iampaviic/IoTGarage/OSTALO/README.md

# OSTALO – sve što ne spada pod PROJEKT ili SOFTWARE

- [literatura.md](literatura.md) – poveznice na dokumentaciju, specifikacije i datasheetove koje koristimo
  (ThingsBoard, MQTT, Mosquitto, OpenCV, Tesseract, ESP32, PlatformIO, senzori, alati); izvor za poglavlje
  *Literatura*
- `literatura/` – (dodaje se po potrebi) PDF-ovi preuzeti s mreže ili dobiveni od nastavnika: datasheetovi,
  članci, specifikacije
- [upute-nastavnika-gitlab.md](upute-nastavnika-gitlab.md) – upute nastavnika za arhiviranje projekta na
  GitLabu (struktura ovog repozitorija slijedi te upute)
