iampaviic/IoTGarage/PREZENTACIJA/README.md

# PREZENTACIJA – završna prezentacija i demonstracija

U uputama nastavnika ovaj dio se zove i *OBRANA*.

- [demo-scenarij.md](demo-scenarij.md) – scenarij demonstracije korak po korak, kontrolirane greške (nečitljiva
  pločica, izlaz bez sesije, …) i kontrolna lista prije prezentacije

Dodaje se do prezentacije:

- datoteka s prezentacijom u originalnom formatu (npr. `.pptx`) i njezina PDF verzija
- slike i grafovi iz prezentacije koji su napravljeni u nekom drugom alatu, u originalnom formatu (mapa `slike/`)
- rezervni video demonstracije (ili poveznica na njega, ako je prevelik za repozitorij)
