iampaviic/IoTGarage/SOFTWARE/rampe/simulator/README.md

# Simulator rampi

- `gate_sim.py` – Python verzija stroja stanja iz `firmware/lib/GateLogic` (ista pravila, isti testovi)
- `gate_simulator.py` – obje rampe na MQTT-u, prisutnost vozila s tipkovnice ili `garage/sim/gate/<gate>/presence`
- `test_gate_sim.py` – `pytest rampe/simulator` (iz mape SOFTWARE)
