iampaviic/IoTGarage/PROJEKT/upravljanje/sastanci/predlozak.md

# Sastanak YYYY-MM-DD (tjedan N)

Prisutni: Patrik ☐ · Lovro ☐ · Toma ☐ · Luka ☐ · Sven ☐ · Lukas ☐ · Anja ☐ · Leo ☐

## 1. Status

| tko | napravljeno od zadnjeg sastanka | plan do sljedećeg | blokira me |
|---|---|---|---|
| Patrik | | | |
| Lovro | | | |
| Toma | | | |
| Luka | | | |
| Sven | | | |
| Lukas | | | |
| Anja | | | |
| Leo | | | |

## 2. Demo integracije
Korak iz plana integracije: … · rezultat: prolaz / pad · bilješke:

## 3. Odluke (prepisati u odluke.md)
- 

## 4. Rizici (ažurirati rizici.md)
- 

## 5. Zadaci
| zadatak | tko | rok |
|---|---|---|
| | | |
