iampaviic/IoTGarage/SOFTWARE/alpr/tablice/plates_A4.pdf

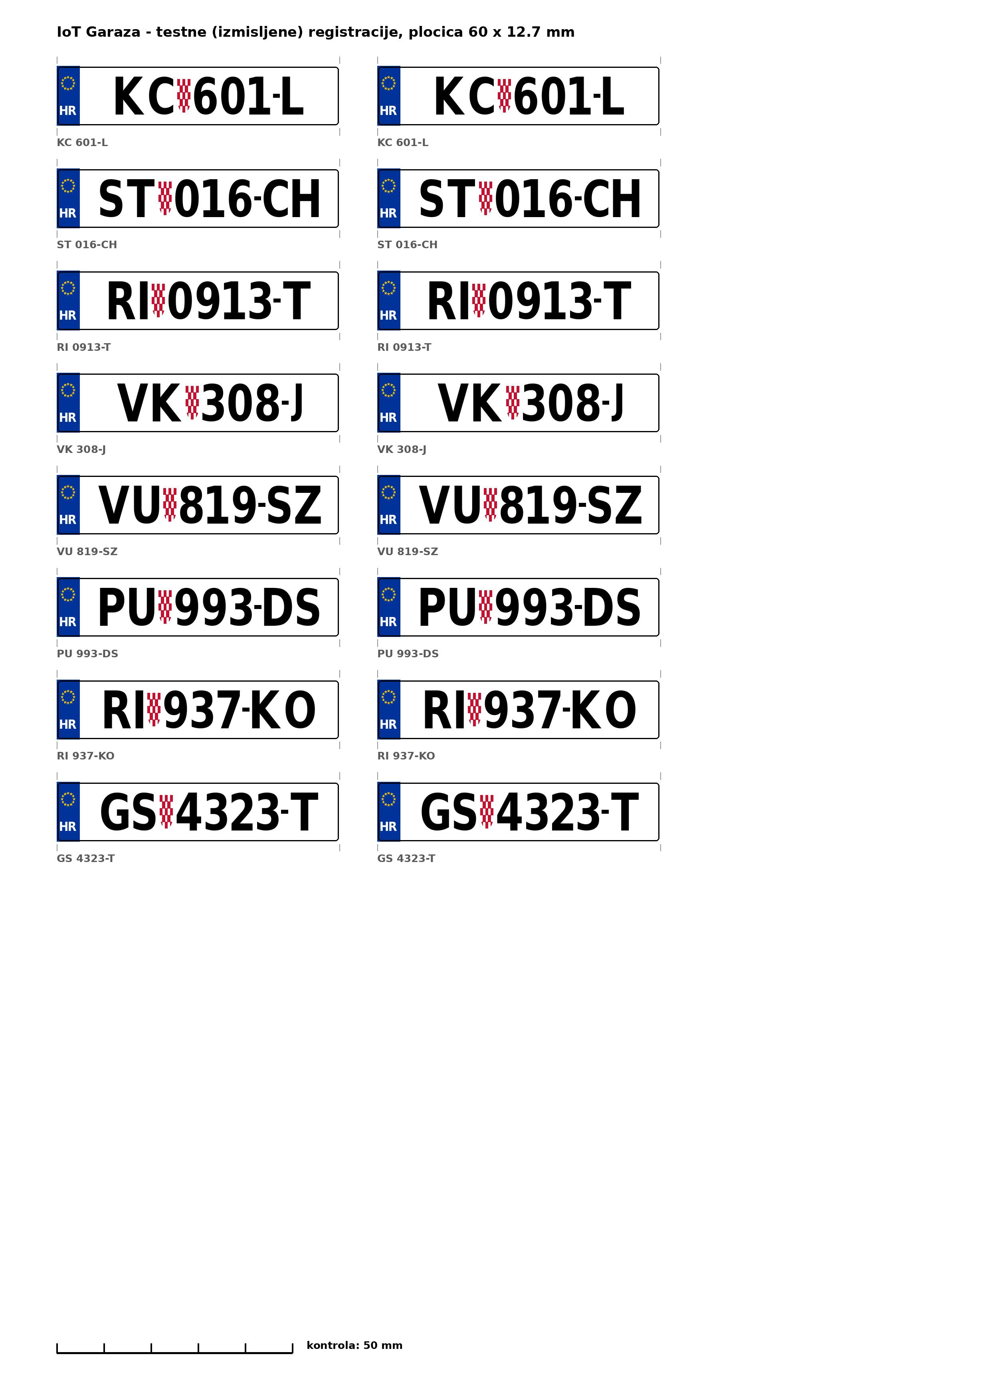
[picture p5: page 1]
