iampaviic/IoTGarage/SOFTWARE/maketa/elektronika/wireviz/cvor-rampi.bom.tsv

Id | Description | Qty | Unit | Designators
1 | Cable, 2 wires | 1.3 | m | R-IZ-TIPKA, R-PWR, R-UL-TIPKA, R-ZUJ
2 | Cable, 3 wires | 2.4 | m | R-IZ-IR, R-IZ-SERVO, R-IZ-SVJ, R-UL-IR, R-UL-SERVO, R-UL-SVJ
3 | Connector, 5 V / 4 A adapter (zajednicko), 2 pins | 1 |  | NAPAJANJE
4 | Connector, ESP32 DevKit V1 (cvor rampi), 14 pins | 1 |  | ESP32-R
5 | Connector, FC-51 (izlaz) - napajati s 3.3 V!, 3 pins | 1 |  | IR-IZ
6 | Connector, FC-51 (ulaz) - napajati s 3.3 V!, 3 pins | 1 |  | IR-UL
7 | Connector, LED crvena+zelena s 220 Ohm (izlaz), 3 pins | 1 |  | SVJ-IZ
8 | Connector, LED crvena+zelena s 220 Ohm (ulaz), 3 pins | 1 |  | SVJ-UL
9 | Connector, SG90 (izlaz), 3 pins | 1 |  | SERVO-IZ
10 | Connector, SG90 (ulaz), 3 pins | 1 |  | SERVO-UL
11 | Connector, aktivna zujalica 3.3 V (opcionalno), 2 pins | 1 |  | ZUJALICA
12 | Connector, tipkalo rucno otvaranje (izlaz), 2 pins | 1 |  | TIPKA-IZ
13 | Connector, tipkalo rucno otvaranje (ulaz), 2 pins | 1 |  | TIPKA-UL
