iampaviic/IoTGarage/SOFTWARE/maketa/3d/sklop/sklop_makete.stl

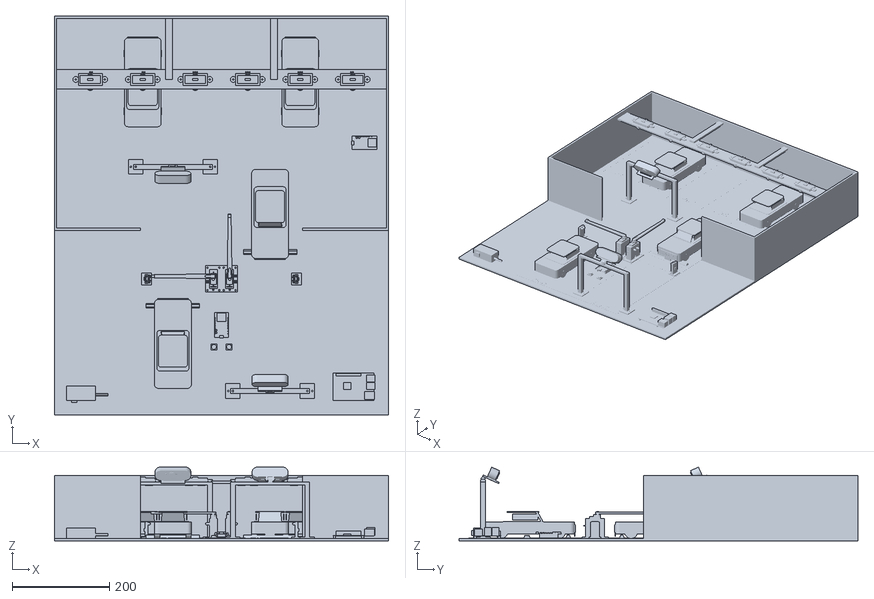
[picture p6: CAD file, 2026-11-04]
SOFTWARE/maketa/3d/sklop/sklop_makete.stl
688.0 x 821.0 x 151.8
