iampaviic/IoTGarage/SOFTWARE/maketa/3d/stl/most_kamere.stl

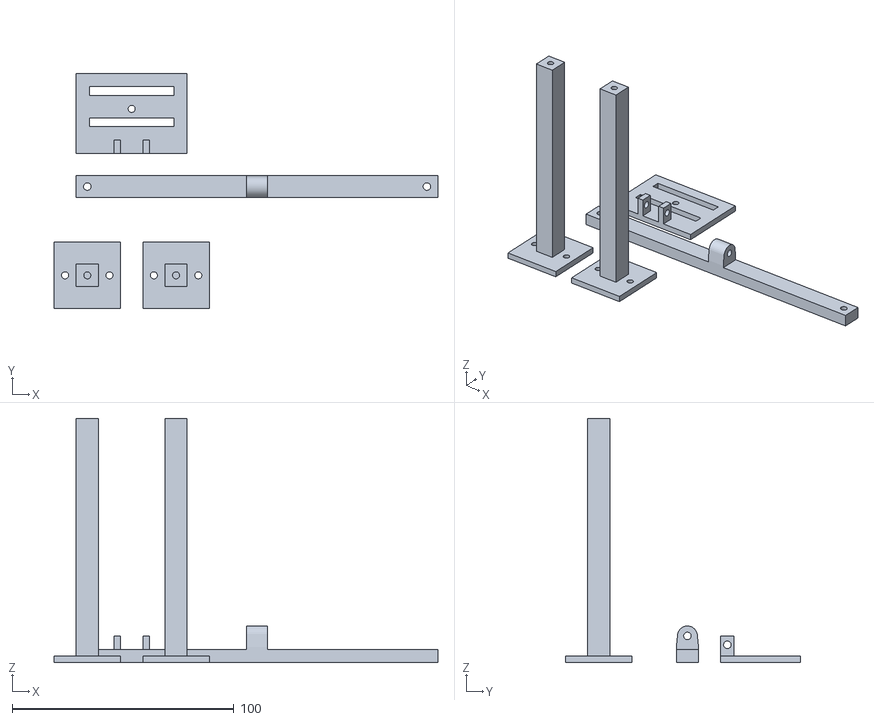
[picture p7: CAD file, 2026-11-04]
SOFTWARE/maketa/3d/stl/most_kamere.stl
173.0 x 106.0 x 110.0
