iampaviic/IoTGarage/SOFTWARE/maketa/3d/stl/rampa_sg90.stl

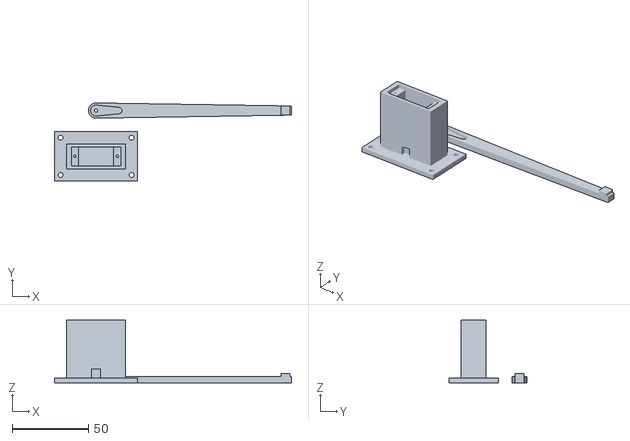
[picture p8: CAD file, 2026-10-21]
SOFTWARE/maketa/3d/stl/rampa_sg90.stl
155.2 x 51.2 x 41.0
