iampaviic/IoTGarage/SOFTWARE/maketa/3d/stl/kabelski_kanal.stl

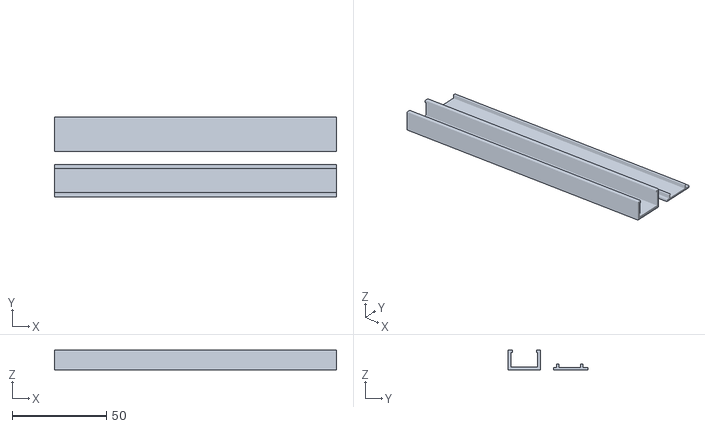
[picture p9: CAD file, 2026-10-21]
SOFTWARE/maketa/3d/stl/kabelski_kanal.stl
150.0 x 42.4 x 10.6
