iampaviic/IoTGarage/SOFTWARE/maketa/3d/stl/nosac_hcsr04.stl

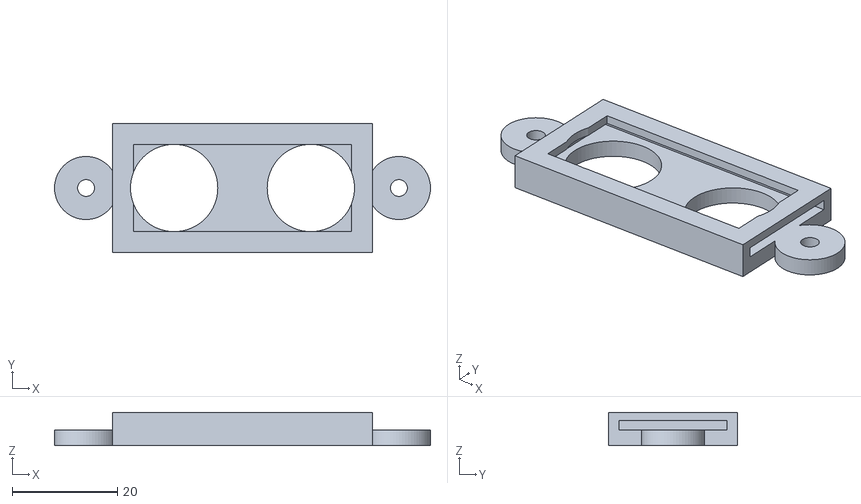
[picture p10: CAD file, 2026-10-21]
SOFTWARE/maketa/3d/stl/nosac_hcsr04.stl
71.5 x 24.5 x 6.30
