iampaviic/IoTGarage/SOFTWARE/maketa/3d/stl/drzac_tablice.stl

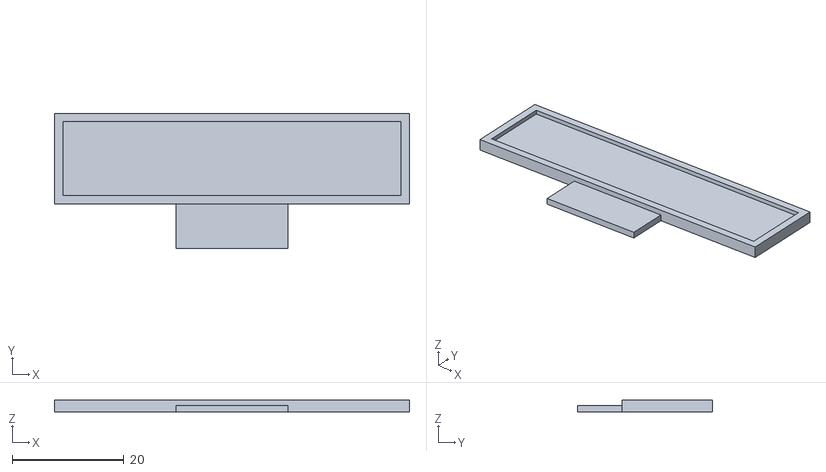
[picture p11: CAD file, 2026-10-21]
SOFTWARE/maketa/3d/stl/drzac_tablice.stl
63.5 x 24.2 x 2.20
