iampaviic/IoTGarage/SOFTWARE/maketa/3d/stl/nosac_ir.stl

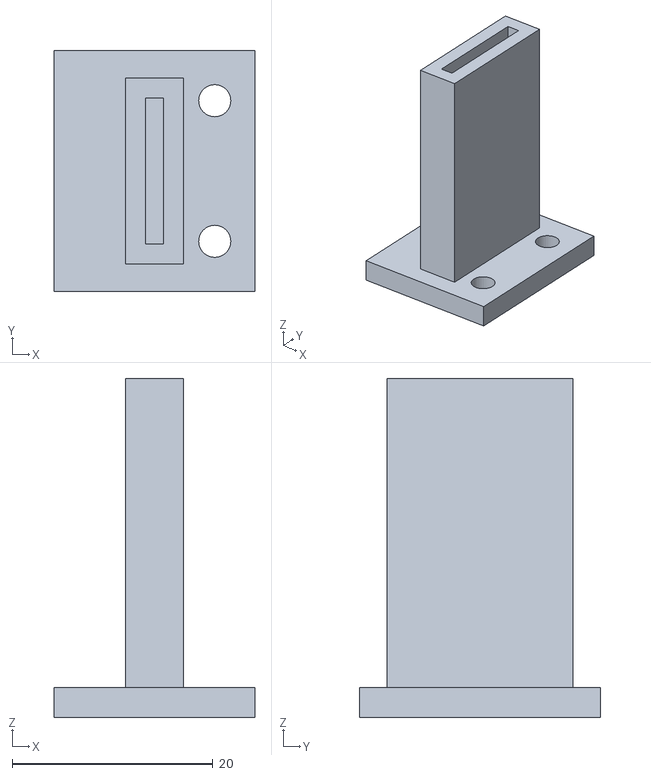
[picture p12: CAD file, 2026-10-21]
SOFTWARE/maketa/3d/stl/nosac_ir.stl
20.0 x 24.0 x 33.8
