iampaviic/IoTGarage/SOFTWARE/maketa/3d/stl/granicnik.stl

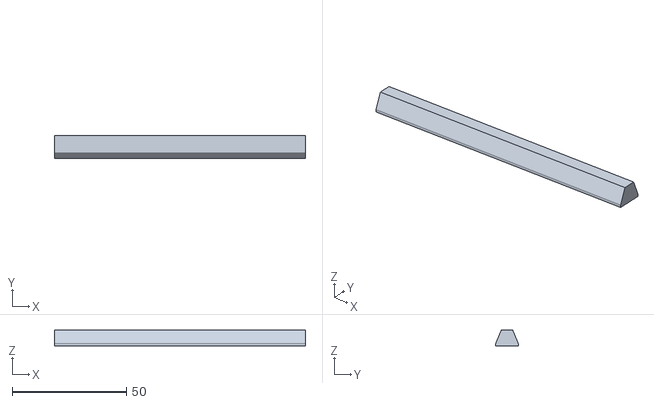
[picture p13: CAD file, 2026-10-21]
SOFTWARE/maketa/3d/stl/granicnik.stl
110.0 x 10.0 x 7.00
