iampaviic/IoTGarage/SOFTWARE/maketa/nacrt/dimenzije.md

# Dimenzije makete (generirano: `python alati/tlocrt.py --scale 24 --spots 6`)

| element | mjera |
|---|---|
| baza makete (Š x D) | 688 x 821 mm |
| parkirno mjesto (Š x D) | 108 x 221 mm |
| prometnica (širina) | 200 mm |
| ulazna/izlazna traka (širina) | 133 mm |
| otok između traka | 67 mm |
| duljina vozila 1:24 (približno) | 183 mm |
| kamera iza crte rampe (na mostu iznad trake) | 200 mm, objektiv 130 mm iznad poda |
| zaustavna crta ispred rampe | 40 mm |
| ruka rampe (donji/gornji rub) | 50 / 58 mm iznad poda |
| HC-SR04 iznad poda (strop mosta) | 113 mm |
