iampaviic/IoTGarage/PROJEKT/maketa/foto-dnevnik/README.md

# Foto-dnevnik izrade

Isporučivi rezultat su i **fotografije faza izrade**. Pravila:

- naziv: `YYYY-MM-DD_faza-N_opis.jpg`, faze iz [nacrt-makete.md](../nacrt-makete.md) §5
- svaka faza: 1 pregledna + 1–2 detalja (spojevi, montaža)
- prije zatvaranja kanala: fotografija ožičenja s vidljivim oznakama kabela

| datum | faza | fotografija | bilješka |
|---|---|---|---|
| | | | |
