iampaviic/IoTGarage/PROJEKT/testiranje/tablica-pragova.md

# Tablica pragova po mjestu

Popunjava se iz izlaza `python SOFTWARE/senzori/tools/kalibracija.py` (datum, uvjeti). Iste vrijednosti idu u
`firmware/include/config.h` → `SPOTS[]`.

Datum kalibracije: ____  · visina mosta senzora: ____ mm · autić: ____

| mjesto | prazno [cm] | σ | auto [cm] | σ | zauzeto ispod [cm] | slobodno iznad [cm] | izgubljenih mjerenja | ocjena |
|---|---|---|---|---|---|---|---|---|
| P01 | | | | | | | | |
| P02 | | | | | | | | |
| P03 | | | | | | | | |
| P04 | | | | | | | | |
| P05 | | | | | | | | |
| P06 | | | | | | | | |

Zadane vrijednosti u firmwareu (prije kalibracije): zauzeto ispod 10,0 cm, slobodno iznad 12,0 cm.
