iampaviic/IoTGarage/(commit log)

2026-10-21 Add ESP32 firmware for spot sensors and gates with native unit tests, sensor calibration and 20x test tools
    Claude-Session: https://claude.ai/code/session_01PjtoX6XUzfEavShmoGESuF
2026-10-21 Add physical model tools (floor plan, camera calculator, 3D parts, wiring diagrams), edge deployment, CI and root test config
    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
    [cvor-rampi.bom.tsv, cvor-senzora.bom.tsv, drzac_tablice.scad, drzac_tablice.stl, granicnik.scad, granicnik.stl, kabelski_kanal.scad, kabelski_kanal.stl]
2026-10-21 Add documentation for all eight team folders: architecture, contract, plans, build guide, test plan and log, user guide
    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
    [popis-komponenti.csv]
2026-10-21 Clarify duplicate MQTT client warning; simulated broken spot reports real fault status
    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
    [main.cpp]
2026-10-21 Ignore duplicate/stale ALPR answers; make camera device mapping a compose override
    - access control: each ALPR attempt gets its own requestId and an answer is only
    used while the transaction is waiting for it, so a QoS 1 redelivery no longer
    produces a second (wrong) decision
    - edge compose: /dev/video0 moved to docker-compose.camera.yml so the base file
    also starts on machines without a camera (ALPR_SOURCE defaults to sim)
    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
2026-10-22 Restructure repository to the GitLab archive layout required by the course
    Top level now follows the professor's instructions: README.TXT, PROJEKT,
    SOFTWARE, PREZENTACIJA, OSTALO, each with a README.TXT.
    - SOFTWARE: all code, one folder per subsystem (ugovor, integracija,
    senzori, rampe, alpr, edge, thingsboard, baza, maketa), plus INSTALL.TXT,
    requirements-dev.txt, pytest.ini, placeholders for the mobile app and
    the final executables
    - PROJEKT: plan projekta (DOCX + PDF + figure sources), final documentation
    chapters, architecture/contract/requirements, management docs, model
    docs, testing docs, screenshots
    - PREZENTACIJA: demo script; OSTALO: literature links and the instruction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
    [cvor-rampi.bom.tsv, cvor-senzora.bom.tsv, drzac_tablice.scad, drzac_tablice.stl, granicnik.scad, granicnik.stl, kabelski_kanal.scad, kabelski_kanal.stl]
2026-10-22 Convert remaining text documents to Markdown
    INSTALL.TXT becomes INSTALL.md and the professor's instructions become
    upute-nastavnika-gitlab.md (content unchanged, only formatted). Links
    and references updated. requirements-dev.txt, the font licence and the
    generated plate list stay .txt because tools read or produce them as
    plain text.
    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
2026-10-28 Gantt: subsystem tasks start in week 3
    Sensor firmware, barrier firmware, ALPR camera/photos, ThingsBoard
    installation and the session model now start on 2.11. (week 3) instead
    of 26.10.; their end dates are unchanged. The plan DOCX/PDF will be
    updated together with the team's new control point dates.
    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
2026-10-28 Architecture block diagram: generic component names, mobile app
    - HC-SR04, SG90 and WS2812 replaced by "UZV senzor", "servo motor" and
    "LED"; the edge subgraph is just "Edge računalo"
    - the mobile app is shown on a phone, reading data from ThingsBoard over
    the REST API (it never talks to the edge computer)
    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
2026-10-28 Architecture: generic component and platform names throughout
    - block diagram: "MQTT broker" instead of Mosquitto
    - component table: UZV senzor, servo motor, IR senzor, LED instead of
    HC-SR04, SG90 and the LED strip
    - deployment: "edge računalo" instead of Raspberry Pi / Jetson Nano; the
    recommendation paragraph now just says any Linux computer with Docker
    or Python >= 3.8 works and points to decision D-004
    - degraded mode and security: "MQTT broker" instead of Mosquitto
    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
2026-10-29 Architecture: variant B that relies on ThingsBoard
    New section 9 next to the existing (variant A) diagrams, which stay:
    - block diagram without the edge MQTT broker, SQLite and bridge: devices
    use ThingsBoard's built-in MQTT transport, sessions live in its database,
    decisions/pricing/alarms run in a rule chain; the edge computer only
    runs ALPR (can be the ThingsBoard laptop)
    - matching entry and exit sequence diagrams (two-way RPC readPlate to the
    ALPR device, RPC open to the gate)
    - A/B comparison and what would change in code if the team picks B
    Checked against the ThingsBoard docs source (MQTT device API, RPC,
    telemetry/attributes storage, rule node reference).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
2026-10-29 Model: 3D assembly of the whole physical model
    sklop/sklop_makete.scad places every printed part (barrier posts and arms,
    HC-SR04 and FC-51 holders, camera bridges, plate holders, wheel stops) on
    the base, together with simplified models of the purchased components
    (komponente.scad): HC-SR04, SG90, FC-51, USB cameras, WS2812 and 5 mm
    LEDs, buttons, ESP32 nodes, Raspberry Pi, power supply and 1:24 cars with
    plates. The layout uses the same formulas as alati/tlocrt.py.
    The assembly computes the camera tilt from the geometry and renders the
    view from each camera: the barrier arm passes above the plate, matching
    kamera_kalkulator.py. izvoz.py exports the PNG views, one STL (viewable
    on GitHub/G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
    [drzac_tablice.scad, granicnik.scad, komponente.scad, most_kamere.scad, most_kamere.stl, nosac_hcsr04.scad, nosac_ir.scad, sklop_makete.scad]
2026-10-29 Architecture: fix variant B flows, make diagram text fit
    Variant B (ThingsBoard) logic:
    - Manual approval now goes through the rule chain: the dashboard button
    sends RPC approve with the plate, the rule chain opens the session and
    only then opens the barrier. Before, the button opened the barrier
    directly, so the same car got NO_ACTIVE_SESSION at the exit.
    - A full garage or a car already inside is denied (GARAGE_FULL /
    ALREADY_INSIDE, as in variant A) instead of going to manual approval.
    - An ALPR RPC timeout counts as low confidence.
    - The exit checks OCR confidence too and has a manual path; both flows
    end with the barrier closing on its own.
    Readability: flowchart nodes and ed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
2026-10-30 Architecture: keep the servo box out of the MQTT label's way
    In both block diagrams the servo node sat right of the gate ESP32, where
    the label of the ESP32's MQTT link is drawn, and covered it. The servo
    is now linked like the spot LED, so it is laid out left of the ESP32.
    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
2026-10-30 Edge deploy: local settings in .env; gate angle comments match the arm
    docker-compose.edge.yml read the ThingsBoard address, gateway token and
    config path from hard-coded values, so setting up the Raspberry Pi meant
    editing a tracked file and getting conflicts on every git pull. They now
    come from edge/deploy/.env (git-ignored, template .env.example), with the
    old values as defaults. docker compose config resolves both with and
    without .env.
    The gate firmware and README said the open arm stands vertical; the
    printed arm swings horizontally, so the comments now say across the lane
    / along the island.
    Claude-Session: https://claude.ai/c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
    [config.h]
2026-10-30 Add the project lead's guide
    One document for the project lead: current state (including that main
    still has the old layout), how the system works, glossary, where things
    are, team and first tasks, deadlines and open decisions, laptop setup,
    full setup with hardware, step-by-step hardware integration with pass
    criteria, troubleshooting and the demo day.
    It describes the GitHub state, so the weekly GitLab tool skips it and the
    README link to it is hidden on GitLab.
    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
2026-11-04 Plan: midterm break, plan submission control point, Gantt sub-tasks
    From the team meeting:
    - Work packages 3-6 (sensors, gates, ALPR, OCR/edge) are split into 3-4
    sub-tasks each on the Gantt chart.
    - Midterms 23.11.-4.12.2026 are on the Gantt as a period without project
    work: bars break across it, and the work after it (calibration, safety
    tests, ALPR/OCR measurements) runs in weeks 8-9, before KT5.
    - Plan submission (20.11.2026) is a new control point, KT3; the later
    ones are renumbered to KT4-KT8 everywhere they are referenced.
    The plan document gets the new Gantt, the KT3 row, a midterm item in the
    phase list and an updated caption and table of contents. The weekly GitLab
    schedul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
2026-11-04 Plan: wiring and dashboards after the midterms
    Napajanje i ožičenje, the monitoring dashboard and the analytics
    dashboard/API now run 7.-20.12. (weeks 8-9) instead of being cut off by
    the midterms. "Baza, mjesta, mostovi, 3D ispis, montaža" is renamed to
    "Baza, mjesta, 3D ispis, montaža". The phase text in the plan document
    and plan-rada.md says what happens after the midterms.
    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
2026-11-04 Plan: mobile app design after the midterms; WBS without "mostovi"
    "Tehnologija, dizajn, dohvat podataka" (mobile app) now runs 7.-20.12.
    instead of being cut off by the midterms; the phase text, plan-rada.md,
    the app README and the lead's guide say so. WBS item 2.2 is now
    "Baza, mjesta".
    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
2026-11-04 Docs: shorter, de-duplicated Markdown
    - names instead of 'osoba N'; one source per fact (pricing, thresholds,
    KT table, install commands, team table, repo rules)
    - vodic-za-voditelja: drop chapters duplicated elsewhere; integration
    steps H0-H11 merged into plan-integracije.md
    - arhitektura: owners in the block table, variant B moved to
    varijanta-b.md; upravljanje/README reduced to the file table
    - module READMEs: one task list instead of task + deliverable tables,
    no message examples or stale test counts
    - evaluate_ocr.py reports only misses (no per-plate / all-readings tables)
    - fixes: mobile app is in scope, camera options no longer called
    variant A/B, stale contract/ and session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
    [popis-komponenti.csv]
2026-11-04 Names instead of person numbers in code comments; substitute pairs as in the plan
    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
    [rampa_sg90.scad]
2026-11-04 GitLab tool: copy executable-bit changes even when the content is unchanged
    The state recorded only blob hashes, so a file whose mode changed in the
    source kept its old mode in the GitLab clone. Modes are now tracked next
    to the blobs (older state files get the current mode as a baseline), and
    write_file also clears the executable bit when the source drops it.
    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
